warhammercasey/MDS_PCB/SilkscreenDecal/robot_dog_pcb_decal_v2/dog_decal_silkscreen_1200dpi.png

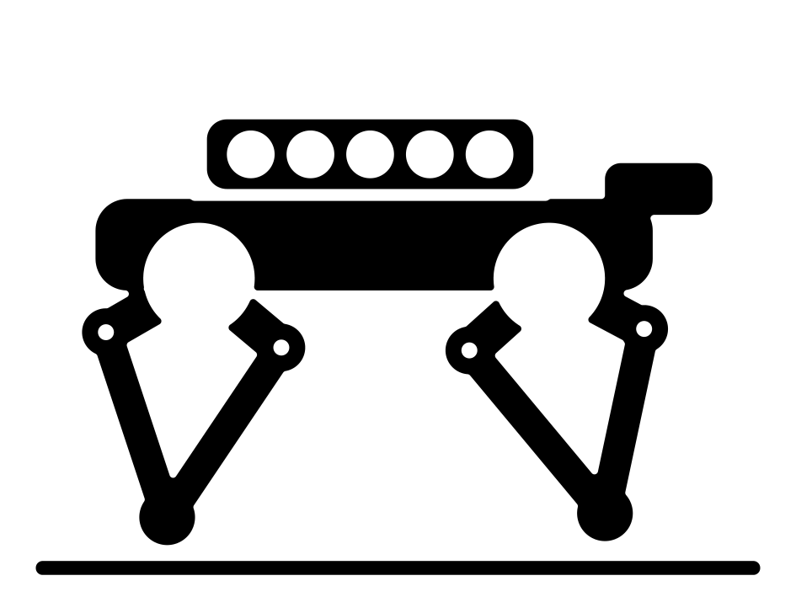
SilkscreenDecal/robot_dog_pcb_decal_v2/dog_decal_silkscreen_1200dpi.png
