warhammercasey/MDS_PCB/SilkscreenDecal/robot_dog_pcb_decal_v2/preview_black.png

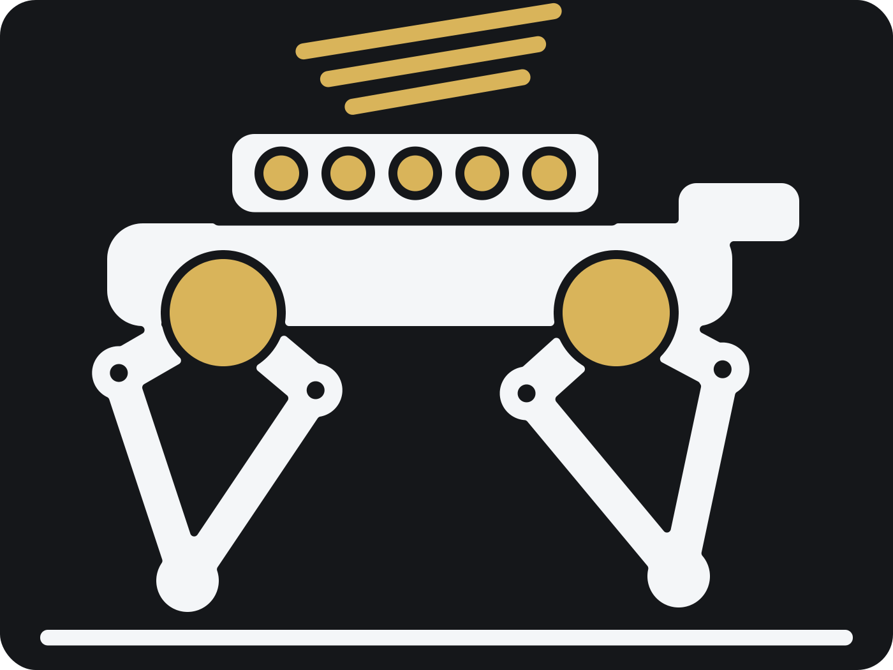
SilkscreenDecal/robot_dog_pcb_decal_v2/preview_black.png
