warhammercasey/MDS_PCB/fpga_pcb.kicad_pcb

## KiCad design fpga_pcb.kicad_pcb (2026-09-30)

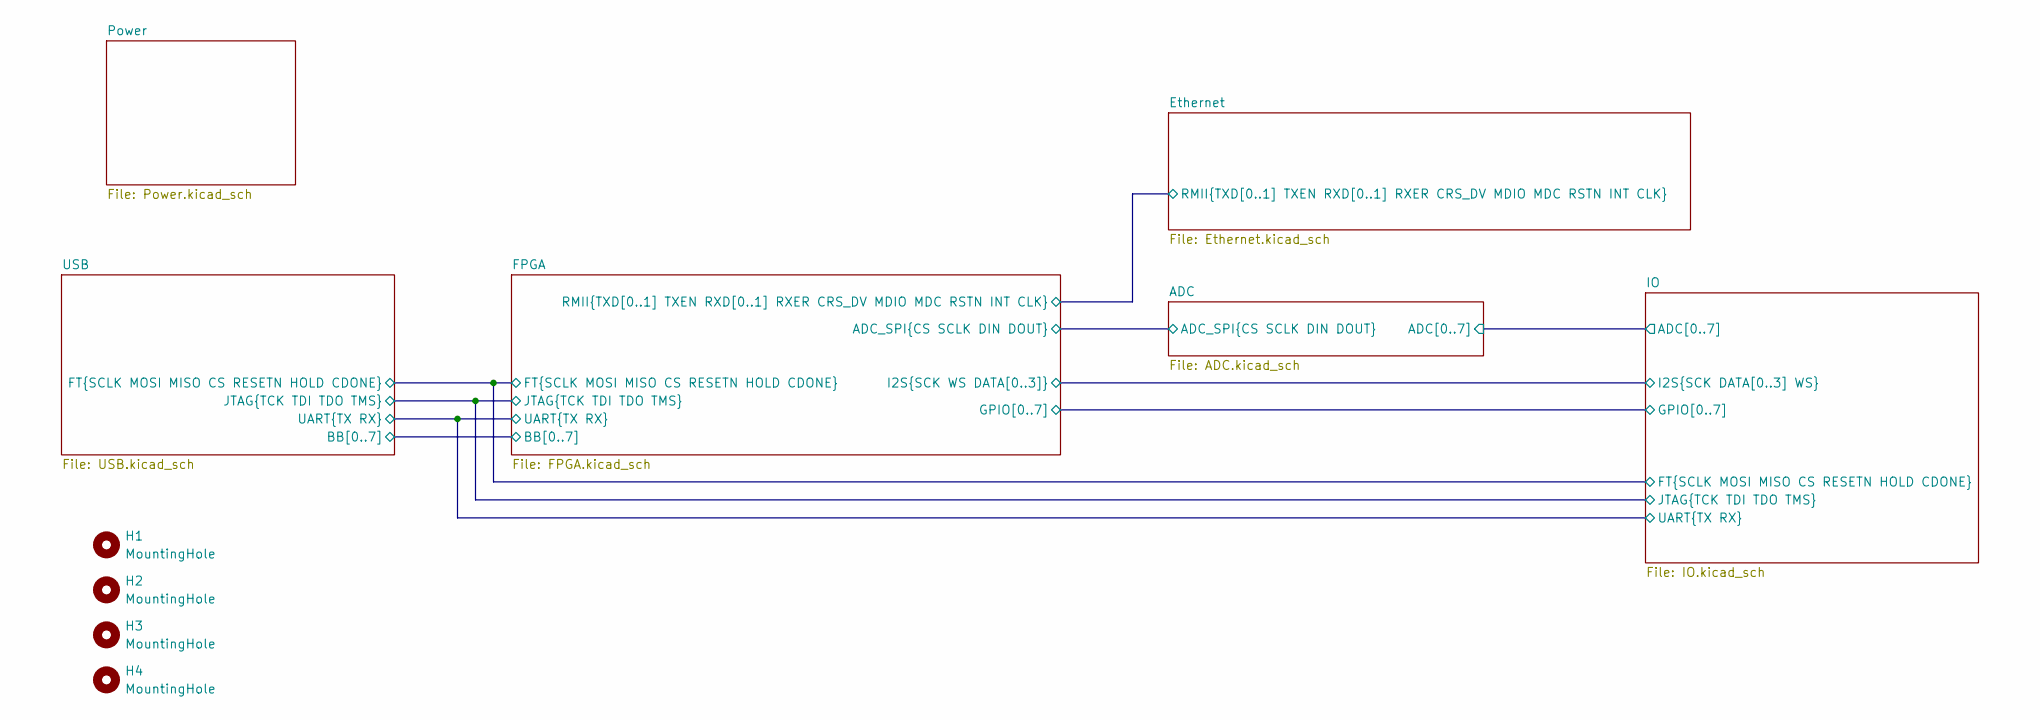
[picture p11: schematic fpga_pcb.kicad_sch, FPGA PCB Top]

Parts:
H1, H2, H3, H4: MountingHole; MountingHole_3.2mm_M3_DIN965_Pad

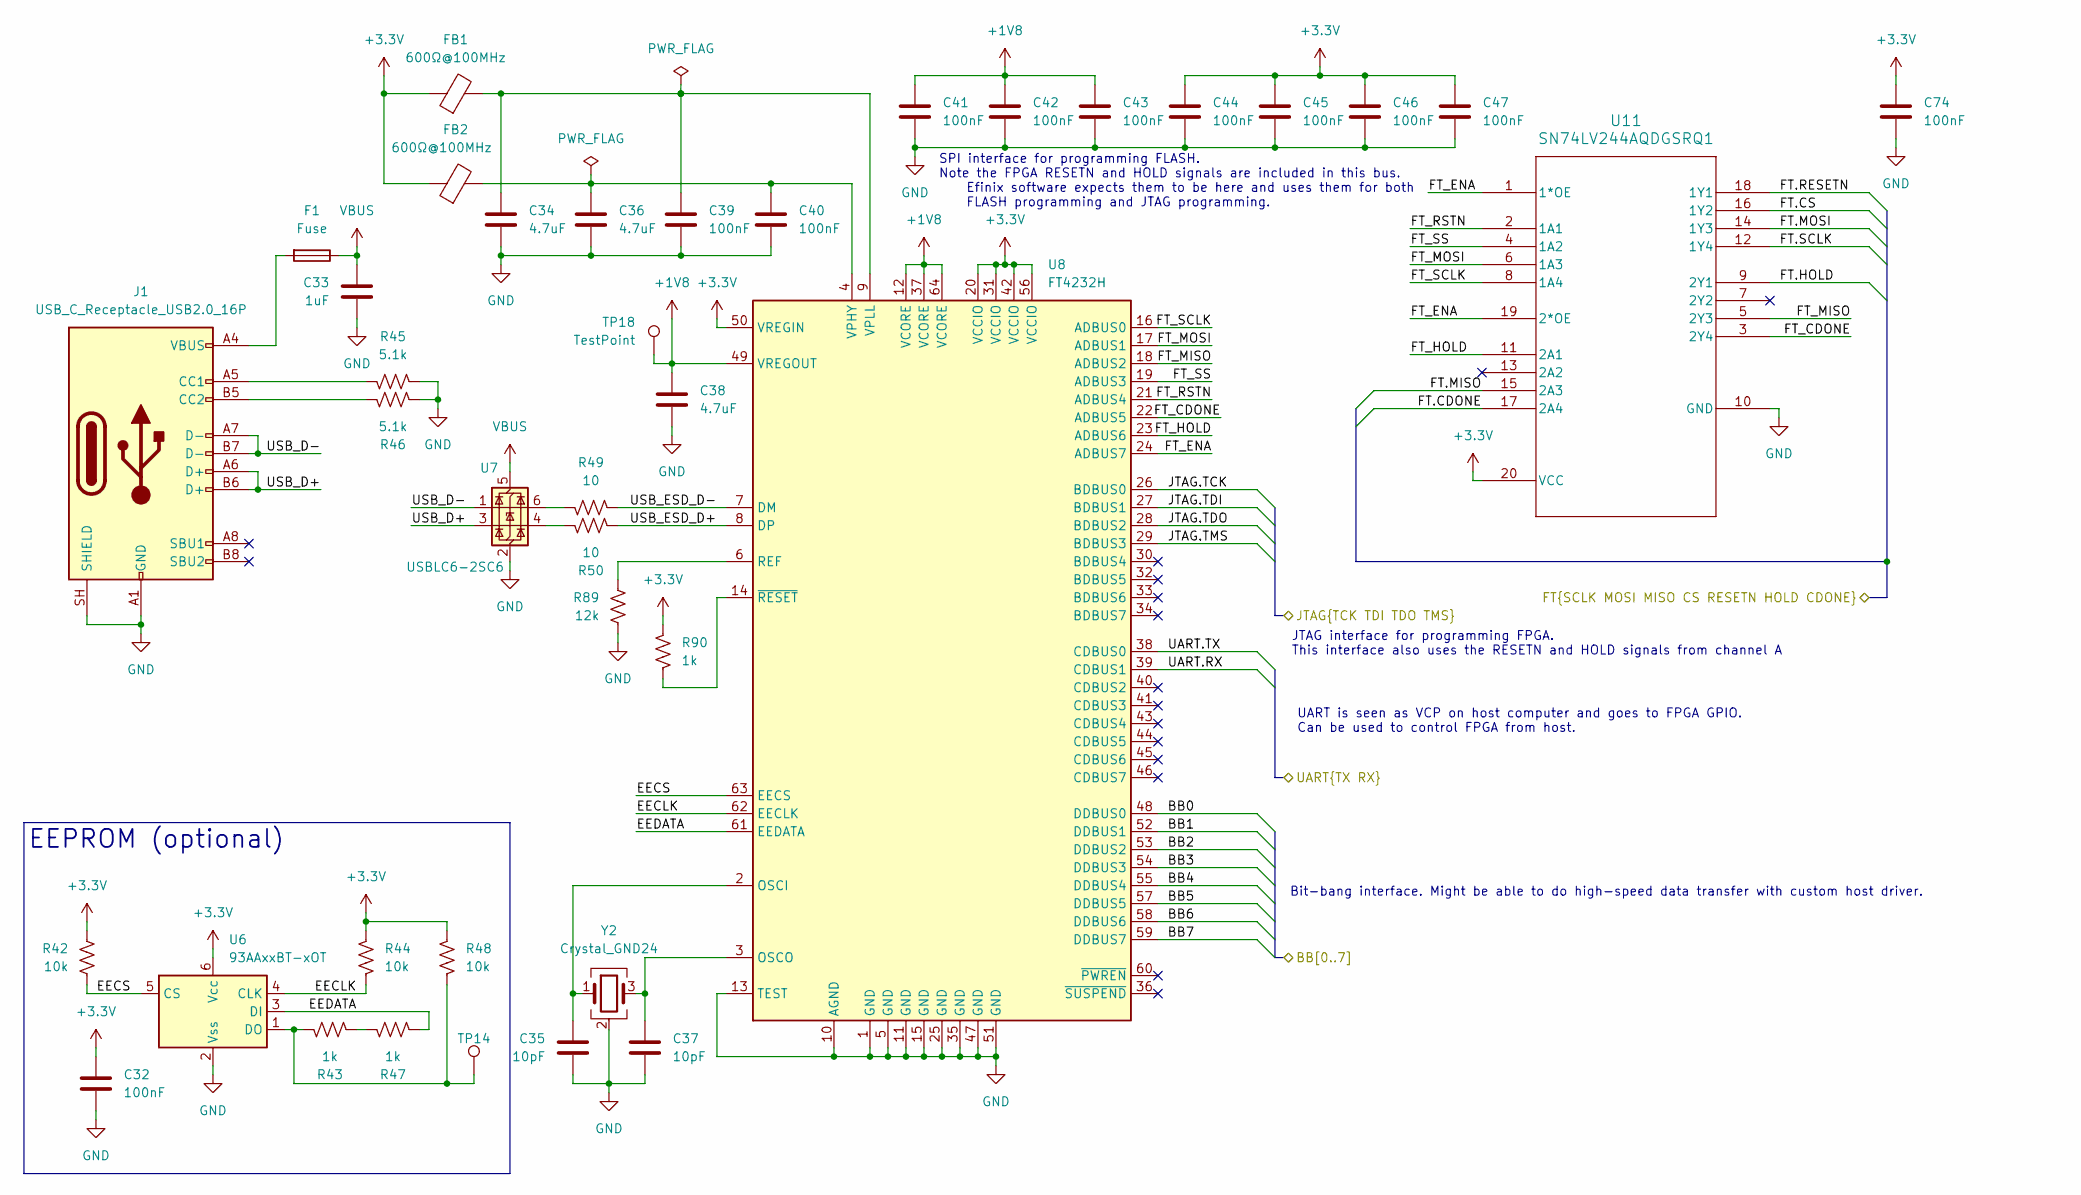
[picture p12: schematic USB.kicad_sch]

Parts:
C32, C39, C40, C41, C42, C43, C44, C45, C46, C47, C74: 100nF; C_0603_1608Metric; Digikey PN 1276-6854-1-ND
C33: 1uF; C_0603_1608Metric; Digikey PN 1276-1859-1-ND
C34, C36, C38: 4.7uF; C_0603_1608Metric; Digikey PN 1276-1045-1-ND
C35, C37: 10pF; C_0603_1608Metric; Digikey PN 1276-2149-1-ND
F1: Fuse; Fuse_0603_1608Metric; Digikey PN 5923-0686F7000-01CT-ND
FB1, FB2: 600Ω@100MHz; L_0603_1608Metric; Digikey PN 490-1014-1-ND
J1: USB_C_Receptacle_USB2.0_16P; USB_C_Receptacle_GCT_USB4105-xx-A_16P_TopMnt_Horizontal; Digikey PN 2073-USB4105-GF-ACT-ND
R42, R44, R48: 10k; R_0603_1608Metric; Digikey PN 311-10KLDCT-ND
R43, R47, R90: 1k; R_0603_1608Metric; Digikey PN 311-1.00KHRCT-ND
R45, R46: 5.1k; R_0603_1608Metric; Digikey PN 311-5.1KGRCT-ND
R49, R50: 10; R_0603_1608Metric; Digikey PN 311-10LDCT-ND
R89: 12k; R_0603_1608Metric; Digikey PN 311-12.0KHRCT-ND
TP14, TP18: TestPoint; TestPoint_Pad_D1.0mm
U6: 93AAxxBT-xOT; SOT-23-6; Digikey PN 93AA56BT-I/OTCT-ND
U7: USBLC6-2SC6; SOT-23-6; Mfr # USBLC6-2SC6; Digikey PN 497-5235-1-ND
U8: FT4232H; LQFP-64_10x10mm_P0.5mm
U11: SN74LV244AQDGSRQ1; VSSOP20_DGS_TEX; Digikey PN 296-SN74LV244AQDGSRQ1CT-ND
Y2: Crystal_GND24; Crystal_SMD_3225-4Pin_3.2x2.5mm; Digikey PN 2151-RH100-12.000-10-3030-TRCT-ND

Connections:
+1V8: C38.1, C41.1, C42.1, C43.1, TP18.1 (1_1), U8.12 (VCORE), U8.37 (VCORE), U8.49 (VREGOUT), U8.64 (VCORE)
+3.3V: C32.1, C44.1, C45.1, C46.1, C47.1, C74.1, FB1.1, FB2.1, R42.1, R44.1, R48.1, R90.1, U6.6 (Vcc), U8.20 (VCCIO), U8.31 (VCCIO), U8.42 (VCCIO), U8.50 (VREGIN), U8.56 (VCCIO), U11.20 (VCC); also elsewhere on the board
/FPGA/BB0: U8.48 (DDBUS0); also elsewhere on the board
/FPGA/BB1: U8.52 (DDBUS1); also elsewhere on the board
/FPGA/BB2: U8.53 (DDBUS2); also elsewhere on the board
/FPGA/BB3: U8.54 (DDBUS3); also elsewhere on the board
/FPGA/BB4: U8.55 (DDBUS4); also elsewhere on the board
/FPGA/BB5: U8.57 (DDBUS5); also elsewhere on the board
/FPGA/BB6: U8.58 (DDBUS6); also elsewhere on the board
/FPGA/BB7: U8.59 (DDBUS7); also elsewhere on the board
/FPGA/FT.CDONE: U11.17 (2A4); also elsewhere on the board
/FPGA/FT.CS: U11.16 (1Y2); also elsewhere on the board
/FPGA/FT.HOLD: U11.9 (2Y1); also elsewhere on the board
/FPGA/FT.MISO: U11.15 (2A3); also elsewhere on the board
/FPGA/FT.MOSI: U11.14 (1Y3); also elsewhere on the board
/FPGA/FT.RESETN: U11.18 (1Y1); also elsewhere on the board
/FPGA/FT.SCLK: U11.12 (1Y4); also elsewhere on the board
/FPGA/JTAG.TCK: U8.26 (BDBUS0); also elsewhere on the board
/FPGA/JTAG.TDI: U8.27 (BDBUS1); also elsewhere on the board
/FPGA/JTAG.TDO: U8.28 (BDBUS2); also elsewhere on the board
/FPGA/JTAG.TMS: U8.29 (BDBUS3); also elsewhere on the board
/FPGA/UART.RX: U8.39 (CDBUS1); also elsewhere on the board
/FPGA/UART.TX: U8.38 (CDBUS0); also elsewhere on the board
/USB/EECLK: R44.2, U6.4 (CLK), U8.62 (EECLK)
/USB/EECS: R42.2, U6.5 (CS), U8.63 (EECS)
/USB/EEDATA: R47.2, U6.3 (DI), U8.61 (EEDATA)
/USB/FT_CDONE: U8.22 (ADBUS5), U11.3 (2Y4)
/USB/FT_ENA: U8.24 (ADBUS7), U11.1 (1*OE), U11.19 (2*OE)
/USB/FT_HOLD: U8.23 (ADBUS6), U11.11 (2A1)
/USB/FT_MISO: U8.18 (ADBUS2), U11.5 (2Y3)
/USB/FT_MOSI: U8.17 (ADBUS1), U11.6 (1A3)
/USB/FT_RSTN: U8.21 (ADBUS4), U11.2 (1A1)
/USB/FT_SCLK: U8.16 (ADBUS0), U11.8 (1A4)
/USB/FT_SS: U8.19 (ADBUS3), U11.4 (1A2)
/USB/USB_D+: J1.A6 (D+), J1.B6 (D+), U7.3 (I/O2)
/USB/USB_D-: J1.A7 (D-), J1.B7 (D-), U7.1 (I/O1)
/USB/USB_ESD_D+: R50.1, U8.8 (DP)
/USB/USB_ESD_D-: R49.1, U8.7 (DM)
GND: C32.2, C33.2, C34.2, C35.2, C36.2, C37.2, C38.2, C39.2, C40.2, C41.2, C42.2, C43.2, C44.2, C45.2, C46.2, C47.2, C74.2, J1.A1 (GND), J1.A12 (GND), J1.B1 (GND), J1.B12 (GND), J1.SH (SHIELD), R45.1, R46.2, R89.2, U6.2 (Vss), U7.2 (GND), U8.1 (GND), U8.5 (GND), U8.10 (AGND), U8.11 (GND), U8.13 (TEST), U8.15 (GND), U8.25 (GND), U8.35 (GND), U8.47 (GND), U8.51 (GND), U11.10 (GND), Y2.2 (G), Y2.4 (G); also elsewhere on the board
unnamed: F1.2, J1.A4 (VBUS), J1.A9 (VBUS), J1.B4 (VBUS), J1.B9 (VBUS)
unnamed: J1.A5 (CC1), R45.2
unnamed: J1.B5 (CC2), R46.1
unnamed: R43.1, R47.1
unnamed: R49.2, U7.6 (I/O1)
unnamed: R50.2, U7.4 (I/O2)
unnamed: R43.2, R48.2, TP14.1 (1_1), U6.1 (DO)
unnamed: C35.1, U8.2 (OSCI), Y2.1
unnamed: C37.1, U8.3 (OSCO), Y2.3
unnamed: R89.1, U8.6 (REF)
unnamed: C36.1, C40.1, FB2.2, U8.4 (VPHY)
unnamed: C34.1, C39.1, FB1.2, U8.9 (VPLL)
unnamed: R90.2, U8.14 (~RESET)
VBUS: C33.1, F1.1, U7.5 (VBUS); also elsewhere on the board

Notes on the sheet:
EEPROM (optional)
SPI interface for programming FLASH. Note the FPGA RESETN and HOLD signals are included in this bus. Efinix software expects them to be here and uses them for both FLASH programming and JTAG programming.
UART is seen as VCP on host computer and goes to FPGA GPIO. Can be used to control FPGA from host.
JTAG interface for programming FPGA. This interface also uses the RESETN and HOLD signals from channel A
Bit-bang interface. Might be able to do high-speed data transfer with custom host driver.

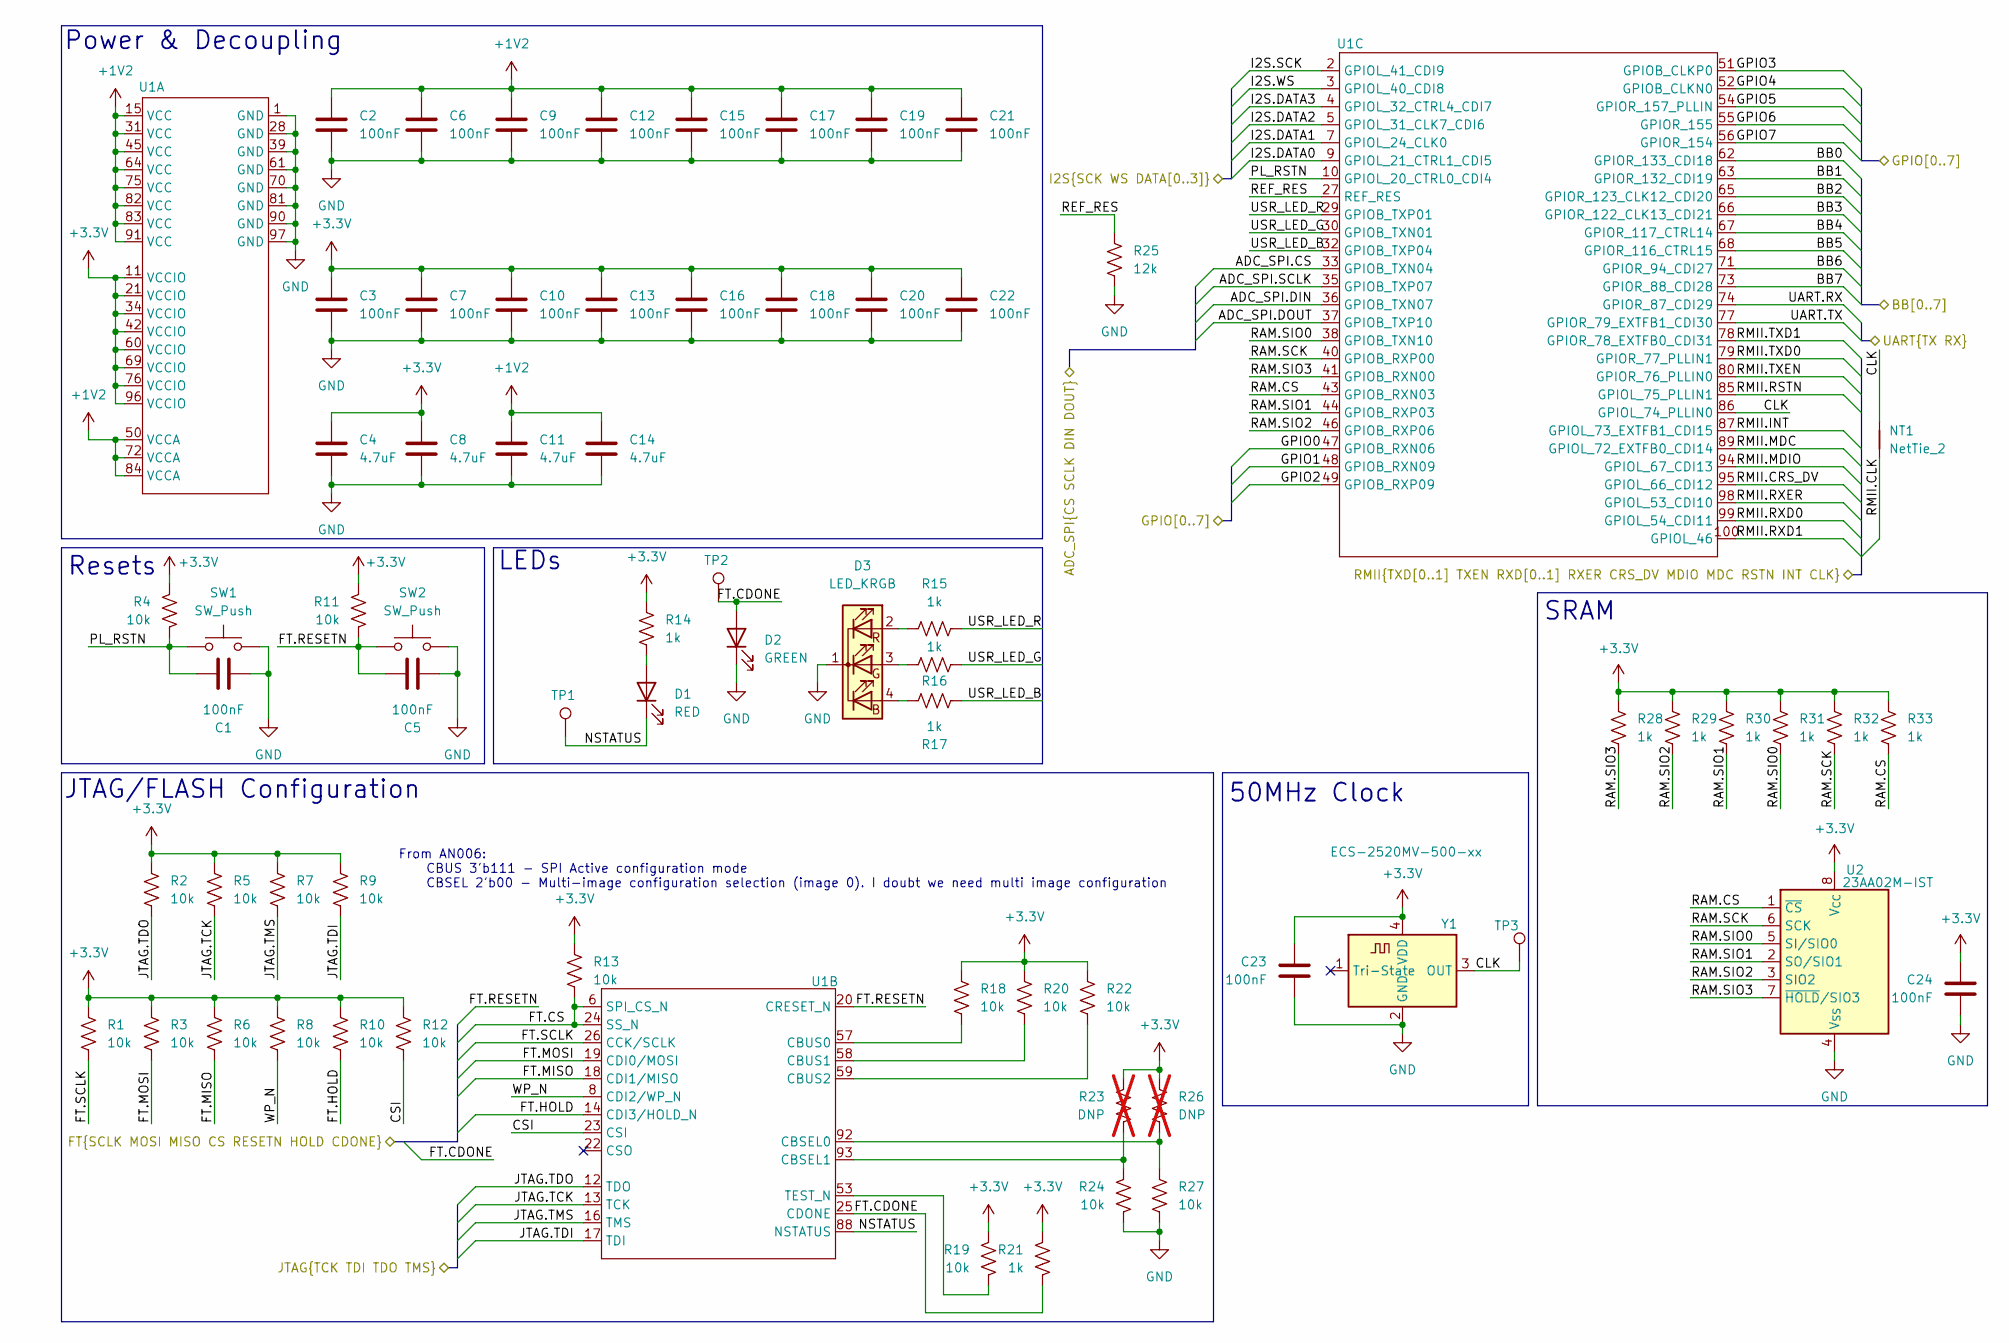
[picture p13: schematic FPGA.kicad_sch]

Parts:
C1, C2, C3, C5, C6, C7, C9, C10, C12, C13, C15, C16, C17, C18, C19, C20, C21, C22, C23, C24: 100nF; C_0603_1608Metric; Digikey PN 1276-6854-1-ND
C4, C8, C11, C14: 4.7uF; C_0603_1608Metric; Digikey PN 1276-1045-1-ND
D1: RED; LED_0603_1608Metric; Digikey PN 754-1123-1-ND
D2: GREEN; LED_0603_1608Metric; Digikey PN 754-1121-1-ND
D3: LED_KRGB; LED_LiteOn_LTST-C19HE1WT; Digikey PN 160-2162-1-ND
NT1: NetTie_2; NetTie-2_SMD_Pad0.5mm
R1, R2, R3, R4, R5, R6, R7, R8, R9, R10, R11, R12, R13, R18, R19, R20, R22, R24, R27: 10k; R_0603_1608Metric; Digikey PN 311-10KLDCT-ND
R14, R15, R16, R17, R21, R28, R29, R30, R31, R32, R33: 1k; R_0603_1608Metric; Digikey PN 311-1.00KHRCT-ND
R23, R26: DNP; R_0603_1608Metric; not fitted
R25: 12k; R_0603_1608Metric; Digikey PN 311-12.0KHRCT-ND
SW1, SW2: SW_Push; SW_Push_1P1T_NO_CK_KMR2; Digikey PN CKN10244CT-ND
TP1, TP2, TP3: TestPoint; TestPoint_Pad_D1.0mm
U1: LQFP-100_14x14mm_P0.5mm; DigiKey PN 2134-T20Q100F3C3-ND
U2: 23AA02M-IST; TSSOP-8_4.4x3mm_P0.65mm; Digikey PN 150-23AA02M-I/ST-ND
Y1: ECS-2520MV-500-xx; Oscillator_SMD_ECS_2520MV-xxx-xx-4Pin_2.5x2.0mm; Digikey PN XC2758CT-ND

Connections:
+1V2: C2.1, C6.1, C9.1, C11.1, C12.1, C14.1, C15.1, C17.1, C19.1, C21.1, U1.15 (VCC), U1.31 (VCC), U1.45 (VCC), U1.50 (VCCA), U1.64 (VCC), U1.72 (VCCA), U1.75 (VCC), U1.82 (VCC), U1.83 (VCC), U1.84 (VCCA), U1.91 (VCC); also elsewhere on the board
+3.3V: C3.1, C4.1, C7.1, C8.1, C10.1, C13.1, C16.1, C18.1, C20.1, C22.1, C23.1, C24.1, R1.1, R2.1, R3.1, R4.1, R5.1, R6.1, R7.1, R8.1, R9.1, R10.1, R11.1, R12.1, R13.1, R14.1, R18.1, R19.1, R20.1, R21.1, R22.1, R23.1, R26.1, R28.1, R29.1, R30.1, R31.1, R32.1, R33.1, U1.11 (VCCIO), U1.21 (VCCIO), U1.34 (VCCIO), U1.42 (VCCIO), U1.60 (VCCIO), U1.69 (VCCIO), U1.76 (VCCIO), U1.96 (VCCIO), U2.8 (V_{CC}), Y1.4 (VDD); also elsewhere on the board
/ADC/ADC_SPI.CS: U1.33 (GPIOB_TXN04); also elsewhere on the board
/ADC/ADC_SPI.DIN: U1.36 (GPIOB_TXN07); also elsewhere on the board
/ADC/ADC_SPI.DOUT: U1.37 (GPIOB_TXP10); also elsewhere on the board
/ADC/ADC_SPI.SCLK: U1.35 (GPIOB_TXP07); also elsewhere on the board
/Ethernet/RMII.CLK: NT1.1; also elsewhere on the board
/Ethernet/RMII.CRS_DV: U1.95 (GPIOL_66_CDI12); also elsewhere on the board
/Ethernet/RMII.INT: U1.87 (GPIOL_73_EXTFB1_CDI15); also elsewhere on the board
/Ethernet/RMII.MDC: U1.89 (GPIOL_72_EXTFB0_CDI14); also elsewhere on the board
/Ethernet/RMII.MDIO: U1.94 (GPIOL_67_CDI13); also elsewhere on the board
/Ethernet/RMII.RSTN: U1.85 (GPIOL_75_PLLIN1); also elsewhere on the board
/Ethernet/RMII.RXD0: U1.99 (GPIOL_54_CDI11); also elsewhere on the board
/Ethernet/RMII.RXD1: U1.100 (GPIOL_46); also elsewhere on the board
/Ethernet/RMII.RXER: U1.98 (GPIOL_53_CDI10); also elsewhere on the board
/Ethernet/RMII.TXD0: U1.79 (GPIOR_77_PLLIN1); also elsewhere on the board
/Ethernet/RMII.TXD1: U1.78 (GPIOR_78_EXTFB0_CDI31); also elsewhere on the board
/Ethernet/RMII.TXEN: U1.80 (GPIOR_76_PLLIN0); also elsewhere on the board
/FPGA/BB0: U1.62 (GPIOR_133_CDI18); also elsewhere on the board
/FPGA/BB1: U1.63 (GPIOR_132_CDI19); also elsewhere on the board
/FPGA/BB2: U1.65 (GPIOR_123_CLK12_CDI20); also elsewhere on the board
/FPGA/BB3: U1.66 (GPIOR_122_CLK13_CDI21); also elsewhere on the board
/FPGA/BB4: U1.67 (GPIOR_117_CTRL14); also elsewhere on the board
/FPGA/BB5: U1.68 (GPIOR_116_CTRL15); also elsewhere on the board
/FPGA/BB6: U1.71 (GPIOR_94_CDI27); also elsewhere on the board
/FPGA/BB7: U1.73 (GPIOR_88_CDI28); also elsewhere on the board
/FPGA/CLK: NT1.2, TP3.1 (1_1), U1.86 (GPIOL_74_PLLIN0), Y1.3 (OUT)
/FPGA/CSI: R12.2, U1.23 (CSI)
/FPGA/FT.CDONE: D2.2 (A), R21.2, TP2.1 (1_1), U1.25 (CDONE); also elsewhere on the board
/FPGA/FT.CS: R13.2, U1.6 (SPI_CS_N), U1.24 (SS_N); also elsewhere on the board
/FPGA/FT.HOLD: R10.2, U1.14 (CDI3/HOLD_N); also elsewhere on the board
/FPGA/FT.MISO: R6.2, U1.18 (CDI1/MISO); also elsewhere on the board
/FPGA/FT.MOSI: R3.2, U1.19 (CDI0/MOSI); also elsewhere on the board
/FPGA/FT.RESETN: C5.2, R11.2, SW2.1, U1.20 (CRESET_N); also elsewhere on the board
/FPGA/FT.SCLK: R1.2, U1.26 (CCK/SCLK); also elsewhere on the board
/FPGA/GPIO0: U1.47 (GPIOB_RXN06); also elsewhere on the board
/FPGA/GPIO1: U1.48 (GPIOB_RXN09); also elsewhere on the board
/FPGA/GPIO2: U1.49 (GPIOB_RXP09); also elsewhere on the board
/FPGA/GPIO3: U1.51 (GPIOB_CLKP0); also elsewhere on the board
/FPGA/GPIO4: U1.52 (GPIOB_CLKN0); also elsewhere on the board
/FPGA/GPIO5: U1.54 (GPIOR_157_PLLIN); also elsewhere on the board
/FPGA/GPIO6: U1.55 (GPIOR_155); also elsewhere on the board
/FPGA/GPIO7: U1.56 (GPIOR_154); also elsewhere on the board
/FPGA/I2S.DATA0: U1.9 (GPIOL_21_CTRL1_CDI5); also elsewhere on the board
/FPGA/I2S.DATA1: U1.7 (GPIOL_24_CLK0); also elsewhere on the board
/FPGA/I2S.DATA2: U1.5 (GPIOL_31_CLK7_CDI6); also elsewhere on the board
/FPGA/I2S.DATA3: U1.4 (GPIOL_32_CTRL4_CDI7); also elsewhere on the board
/FPGA/I2S.SCK: U1.2 (GPIOL_41_CDI9); also elsewhere on the board
/FPGA/I2S.WS: U1.3 (GPIOL_40_CDI8); also elsewhere on the board
/FPGA/JTAG.TCK: R5.2, U1.13 (TCK); also elsewhere on the board
/FPGA/JTAG.TDI: R9.2, U1.17 (TDI); also elsewhere on the board
/FPGA/JTAG.TDO: R2.2, U1.12 (TDO); also elsewhere on the board
/FPGA/JTAG.TMS: R7.2, U1.16 (TMS); also elsewhere on the board
/FPGA/NSTATUS: D1.1 (K), TP1.1 (1_1), U1.88 (NSTATUS)
/FPGA/PL_RSTN: C1.2, R4.2, SW1.1, U1.10 (GPIOL_20_CTRL0_CDI4)
/FPGA/RAM.CS: R33.2, U1.43 (GPIOB_RXN03), U2.1 (~CS)
/FPGA/RAM.SCK: R32.2, U1.40 (GPIOB_RXP00), U2.6 (SCK)
/FPGA/RAM.SIO0: R31.2, U1.38 (GPIOB_TXN10), U2.5 (SI/SIO0)
/FPGA/RAM.SIO1: R30.2, U1.44 (GPIOB_RXP03), U2.2 (SO/SIO1)
/FPGA/RAM.SIO2: R29.2, U1.46 (GPIOB_RXP06), U2.3 (SIO2)
/FPGA/RAM.SIO3: R28.2, U1.41 (GPIOB_RXN00), U2.7 (~HOLD/SIO3)
/FPGA/REF_RES: R25.1, U1.27 (REF_RES)
/FPGA/UART.RX: U1.74 (GPIOR_87_CDI29); also elsewhere on the board
/FPGA/UART.TX: U1.77 (GPIOR_79_EXTFB1_CDI30); also elsewhere on the board
/FPGA/USR_LED_B: R17.1, U1.32 (GPIOB_TXP04)
/FPGA/USR_LED_G: R16.2, U1.30 (GPIOB_TXN01)
/FPGA/USR_LED_R: R15.2, U1.29 (GPIOB_TXP01)
/FPGA/WP_N: R8.2, U1.8 (CDI2/WP_N)
GND: C1.1, C2.2, C3.2, C4.2, C5.1, C6.2, C7.2, C8.2, C9.2, C10.2, C11.2, C12.2, C13.2, C14.2, C15.2, C16.2, C17.2, C18.2, C19.2, C20.2, C21.2, C22.2, C23.2, C24.2, D2.1 (K), D3.1 (K), R24.2, R25.2, R27.2, SW1.2, SW2.2, U1.1 (GND), U1.28 (GND), U1.39 (GND), U1.61 (GND), U1.70 (GND), U1.81 (GND), U1.90 (GND), U1.97 (GND), U2.4 (V_{SS}), Y1.2 (GND); also elsewhere on the board
unnamed: D1.2 (A), R14.2
unnamed: D3.4 (BA), R17.2
unnamed: D3.3 (GA), R16.1
unnamed: D3.2 (RA), R15.1
unnamed: R26.2, R27.1, U1.92 (CBSEL0)
unnamed: R23.2, R24.1, U1.93 (CBSEL1)
unnamed: R18.2, U1.57 (CBUS0)
unnamed: R20.2, U1.58 (CBUS1)
unnamed: R22.2, U1.59 (CBUS2)
unnamed: R19.2, U1.53 (TEST_N)

Notes on the sheet:
JTAG/FLASH Configuration
LEDs
SRAM
Power & Decoupling
50MHz Clock
Resets
From AN006: CBUS 3'b111 - SPI Active configuration mode CBSEL 2'b00 - Multi-image configuration selection (image 0). I doubt we need multi image configuration

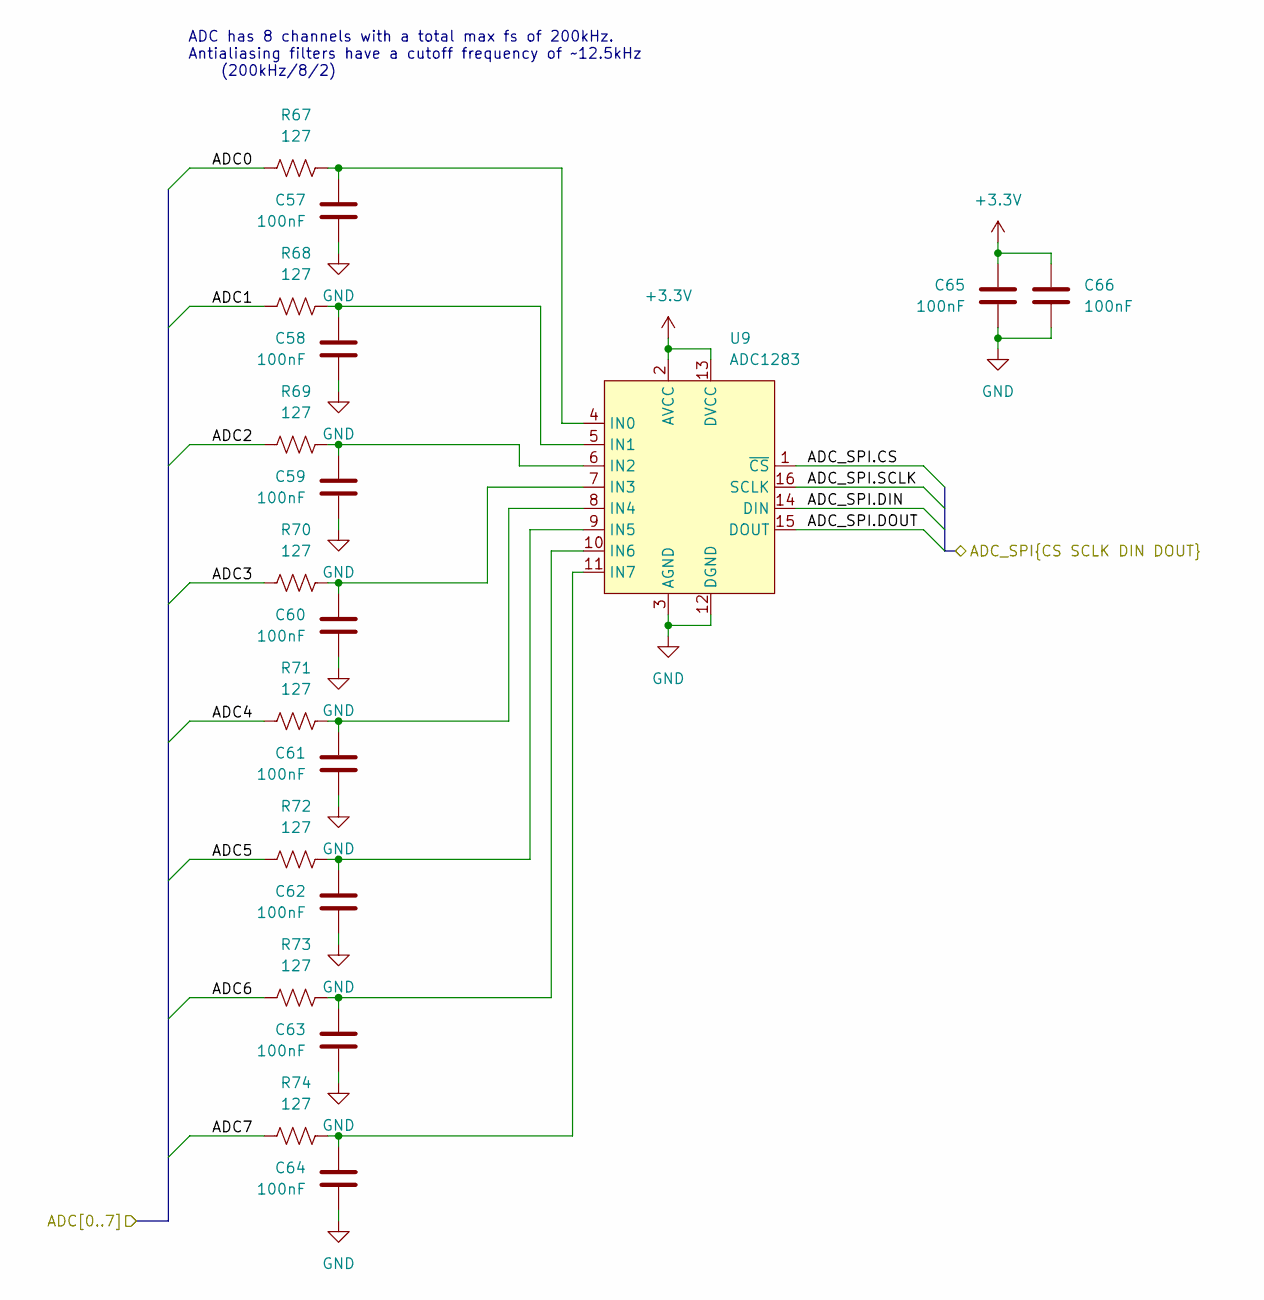
[picture p14: schematic ADC.kicad_sch]

Parts:
C57, C58, C59, C60, C61, C62, C63, C64, C65, C66: 100nF; C_0603_1608Metric; Digikey PN 1276-6854-1-ND
R67, R68, R69, R70, R71, R72, R73, R74: 127; R_0603_1608Metric; Digikey PN 311-127HRCT-ND
U9: ADC1283; TSSOP-16_4.4x5mm_P0.65mm; Digikey PN ADC088S022CIMTX/NOPBCT-ND

Connections:
+3.3V: C65.1, C66.1, U9.2 (AVCC), U9.13 (DVCC); also elsewhere on the board
/ADC/ADC0: R67.1; also elsewhere on the board
/ADC/ADC1: R68.1; also elsewhere on the board
/ADC/ADC2: R69.1; also elsewhere on the board
/ADC/ADC3: R70.1; also elsewhere on the board
/ADC/ADC4: R71.1; also elsewhere on the board
/ADC/ADC5: R72.1; also elsewhere on the board
/ADC/ADC6: R73.1; also elsewhere on the board
/ADC/ADC7: R74.1; also elsewhere on the board
/ADC/ADC_SPI.CS: U9.1 (~CS); also elsewhere on the board
/ADC/ADC_SPI.DIN: U9.14 (DIN); also elsewhere on the board
/ADC/ADC_SPI.DOUT: U9.15 (DOUT); also elsewhere on the board
/ADC/ADC_SPI.SCLK: U9.16 (SCLK); also elsewhere on the board
GND: C57.2, C58.2, C59.2, C60.2, C61.2, C62.2, C63.2, C64.2, C65.2, C66.2, U9.3 (AGND), U9.12 (DGND); also elsewhere on the board
unnamed: C57.1, R67.2, U9.4 (IN0)
unnamed: C58.1, R68.2, U9.5 (IN1)
unnamed: C59.1, R69.2, U9.6 (IN2)
unnamed: C60.1, R70.2, U9.7 (IN3)
unnamed: C61.1, R71.2, U9.8 (IN4)
unnamed: C62.1, R72.2, U9.9 (IN5)
unnamed: C63.1, R73.2, U9.10 (IN6)
unnamed: C64.1, R74.2, U9.11 (IN7)

Notes on the sheet:
ADC has 8 channels with a total max fs of 200kHz. Antialiasing filters have a cutoff frequency of ~12.5kHz (200kHz/8/2)

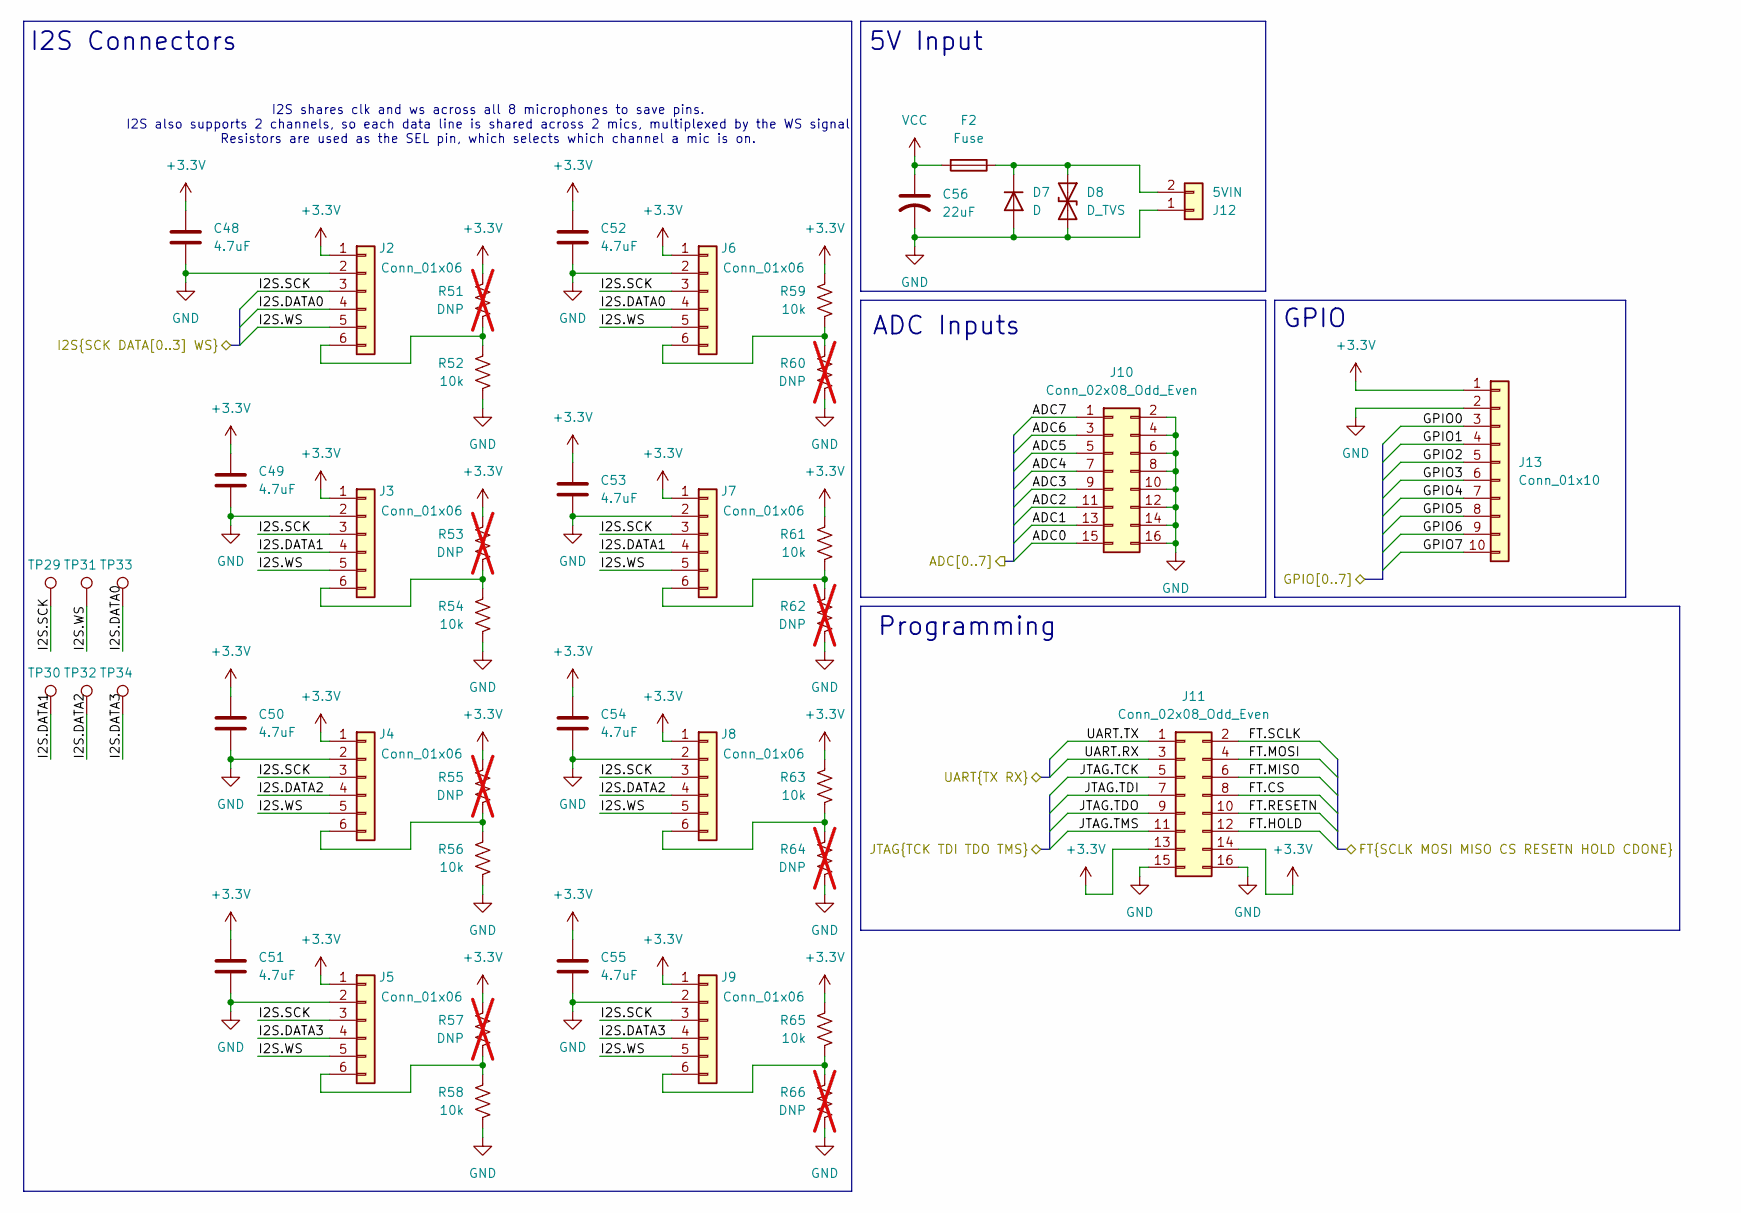
[picture p15: schematic IO.kicad_sch, I/O]

Parts:
C48, C49, C50, C51, C52, C53, C54, C55: 4.7uF; C_0603_1608Metric; Digikey PN 1276-1045-1-ND
C56: 22uF; C_Radial_D5.0mm_H7.0mm_P2.00mm; Digikey PN P814-ND
D7: D; D_SMA; Digikey PN 5399-SS32CT-ND
D8: D_TVS; D_SMA; Digikey PN 5399-SMAJ6.0ACT-ND
F2: Fuse; Fuse_0603_1608Metric; Digikey PN 5923-0686F7000-01CT-ND
J2, J3, J4, J5, J6, J7, J8, J9: Conn_01x06; JST_GH_BM06B-GHS-TBT_1x06-1MP_P1.25mm_Vertical; Digikey PN 455-BM06B-GHS-TBTCT-ND
J10, J11: Conn_02x08_Odd_Even; PinHeader_2x08_P2.54mm_Vertical; Digikey PN 4627-PH254V-216-6TBKG126-ND
J12: 5VIN; JST_XH_B2B-XH-A_1x02_P2.50mm_Vertical; Digikey PN 455-B2B-XH-A-ND
J13: Conn_01x10; PinHeader_1x10_P2.54mm_Vertical; Digikey PN 2057-PH1-10-UA-ND
R51, R53, R55, R57, R60, R62, R64, R66: DNP; R_0603_1608Metric; not fitted
R52, R54, R56, R58, R59, R61, R63, R65: 10k; R_0603_1608Metric; Digikey PN 311-10KLDCT-ND
TP29, TP30, TP31, TP32, TP33, TP34: TestPoint; TestPoint_Pad_D1.0mm

Connections:
+3.3V: C48.1, C49.1, C50.1, C51.1, C52.1, C53.1, C54.1, C55.1, J2.1, J3.1, J4.1, J5.1, J6.1, J7.1, J8.1, J9.1, J11.13, J11.14, J13.1, R51.1, R53.1, R55.1, R57.1, R59.1, R61.1, R63.1, R65.1; also elsewhere on the board
/ADC/ADC0: J10.15; also elsewhere on the board
/ADC/ADC1: J10.13; also elsewhere on the board
/ADC/ADC2: J10.11; also elsewhere on the board
/ADC/ADC3: J10.9; also elsewhere on the board
/ADC/ADC4: J10.7; also elsewhere on the board
/ADC/ADC5: J10.5; also elsewhere on the board
/ADC/ADC6: J10.3; also elsewhere on the board
/ADC/ADC7: J10.1; also elsewhere on the board
/FPGA/FT.CS: J11.8; also elsewhere on the board
/FPGA/FT.HOLD: J11.12; also elsewhere on the board
/FPGA/FT.MISO: J11.6; also elsewhere on the board
/FPGA/FT.MOSI: J11.4; also elsewhere on the board
/FPGA/FT.RESETN: J11.10; also elsewhere on the board
/FPGA/FT.SCLK: J11.2; also elsewhere on the board
/FPGA/GPIO0: J13.3; also elsewhere on the board
/FPGA/GPIO1: J13.4; also elsewhere on the board
/FPGA/GPIO2: J13.5; also elsewhere on the board
/FPGA/GPIO3: J13.6; also elsewhere on the board
/FPGA/GPIO4: J13.7; also elsewhere on the board
/FPGA/GPIO5: J13.8; also elsewhere on the board
/FPGA/GPIO6: J13.9; also elsewhere on the board
/FPGA/GPIO7: J13.10; also elsewhere on the board
/FPGA/I2S.DATA0: J2.4, J6.4, TP33.1 (1_1); also elsewhere on the board
/FPGA/I2S.DATA1: J3.4, J7.4, TP30.1 (1_1); also elsewhere on the board
/FPGA/I2S.DATA2: J4.4, J8.4, TP32.1 (1_1); also elsewhere on the board
/FPGA/I2S.DATA3: J5.4, J9.4, TP34.1 (1_1); also elsewhere on the board
/FPGA/I2S.SCK: J2.3, J3.3, J4.3, J5.3, J6.3, J7.3, J8.3, J9.3, TP29.1 (1_1); also elsewhere on the board
/FPGA/I2S.WS: J2.5, J3.5, J4.5, J5.5, J6.5, J7.5, J8.5, J9.5, TP31.1 (1_1); also elsewhere on the board
/FPGA/JTAG.TCK: J11.5; also elsewhere on the board
/FPGA/JTAG.TDI: J11.7; also elsewhere on the board
/FPGA/JTAG.TDO: J11.9; also elsewhere on the board
/FPGA/JTAG.TMS: J11.11; also elsewhere on the board
/FPGA/UART.RX: J11.3; also elsewhere on the board
/FPGA/UART.TX: J11.1; also elsewhere on the board
GND: C48.2, C49.2, C50.2, C51.2, C52.2, C53.2, C54.2, C55.2, C56.2, D7.2 (A), D8.2 (A2), J2.2, J3.2, J4.2, J5.2, J6.2, J7.2, J8.2, J9.2, J10.2, J10.4, J10.6, J10.8, J10.10, J10.12, J10.14, J10.16, J11.15, J11.16, J12.1, J13.2, R52.2, R54.2, R56.2, R58.2, R60.2, R62.2, R64.2, R66.2; also elsewhere on the board
unnamed: D7.1 (K), D8.1 (A1), F2.1, J12.2
unnamed: J2.6, R51.2, R52.1
unnamed: J3.6, R53.2, R54.1
unnamed: J4.6, R55.2, R56.1
unnamed: J5.6, R57.2, R58.1
unnamed: J6.6, R59.2, R60.1
unnamed: J7.6, R61.2, R62.1
unnamed: J8.6, R63.2, R64.1
unnamed: J9.6, R65.2, R66.1
VCC: C56.1, F2.2; also elsewhere on the board

Notes on the sheet:
I2S Connectors
ADC Inputs
I2S shares clk and ws across all 8 microphones to save pins. I2S also supports 2 channels, so each data line is shared across 2 mics, multiplexed by the WS signal Resistors are used as the SEL pin, which selects which channel a mic is on.
Programming
GPIO
5V Input
