warhammercasey/MDS_PCB/fpga_pcb.kicad_pcb

## KiCad design fpga_pcb.kicad_pcb (continued)

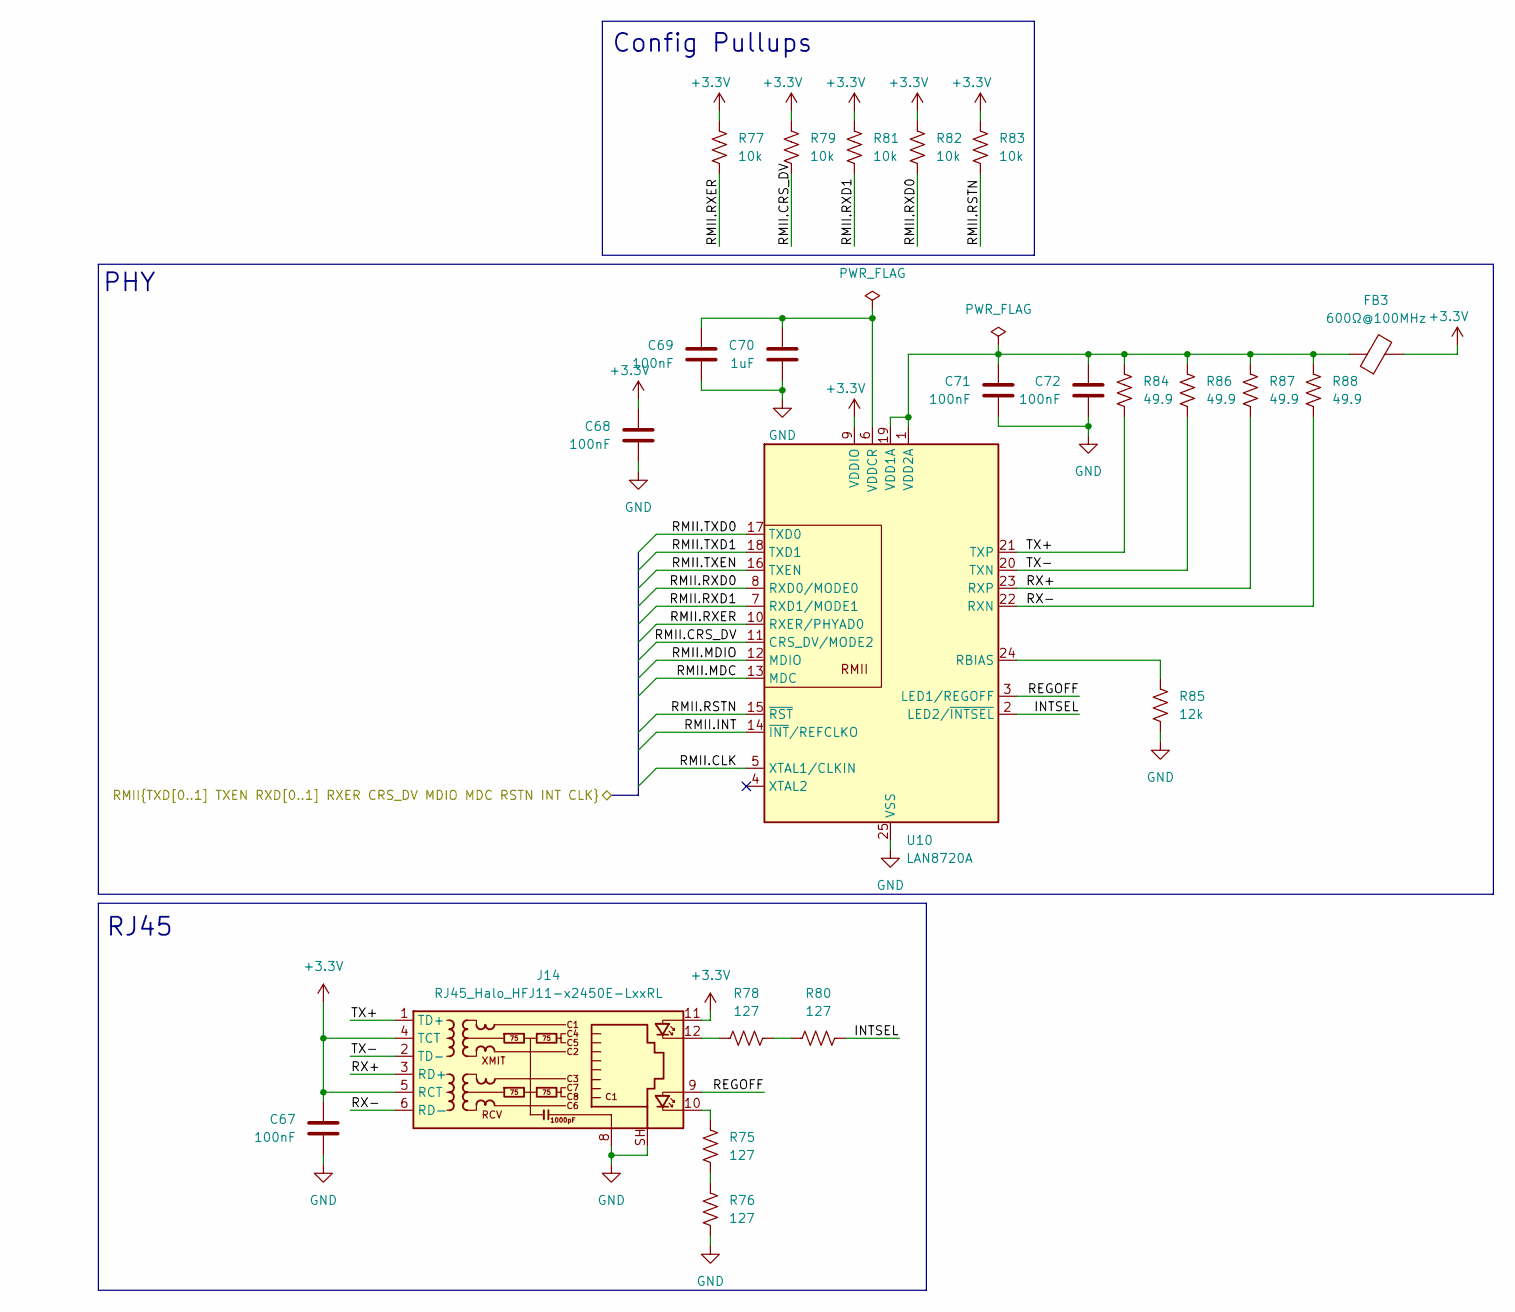
[picture p16: schematic Ethernet.kicad_sch]

Parts:
C67, C68, C69, C71, C72: 100nF; C_0603_1608Metric; Digikey PN 1276-6854-1-ND
C70: 1uF; C_0603_1608Metric; Digikey PN 1276-1859-1-ND
FB3: 600Ω@100MHz; L_0603_1608Metric; Digikey PN 490-1014-1-ND
J14: RJ45_Halo_HFJ11-x2450E-LxxRL; RJ45_HALO_HFJ11-x2450E-LxxRL_Horizontal; Digikey PN 5843-HFJ11-2450E-L12RL-ND
R75, R76, R78, R80: 127; R_0603_1608Metric; Digikey PN 311-127HRCT-ND
R77, R79, R81, R82, R83: 10k; R_0603_1608Metric; Digikey PN 311-10KLDCT-ND
R84, R86, R87, R88: 49.9; R_0603_1608Metric; Digikey PN 311-49.9HRCT-ND
R85: 12k; R_0603_1608Metric; Digikey PN 311-12.0KHRCT-ND
U10: LAN8720A; VQFN-24-1EP_4x4mm_P0.5mm_EP2.5x2.5mm_ThermalVias; Digikey PN LAN8720A-CP-CT-ND

Connections:
+3.3V: C67.1, C68.1, FB3.2, J14.4 (TCT), J14.5 (RCT), J14.11, R77.1, R79.1, R81.1, R82.1, R83.1, U10.9 (VDDIO); also elsewhere on the board
/Ethernet/INTSEL: R80.1, U10.2 (LED2/~INTSEL)
/Ethernet/REGOFF: J14.9, U10.3 (LED1/REGOFF)
/Ethernet/RMII.CLK: U10.5 (XTAL1/CLKIN); also elsewhere on the board
/Ethernet/RMII.CRS_DV: R79.2, U10.11 (CRS_DV/MODE2); also elsewhere on the board
/Ethernet/RMII.INT: U10.14 (~INT/REFCLKO); also elsewhere on the board
/Ethernet/RMII.MDC: U10.13 (MDC); also elsewhere on the board
/Ethernet/RMII.MDIO: U10.12 (MDIO); also elsewhere on the board
/Ethernet/RMII.RSTN: R83.2, U10.15 (~RST); also elsewhere on the board
/Ethernet/RMII.RXD0: R82.2, U10.8 (RXD0/MODE0); also elsewhere on the board
/Ethernet/RMII.RXD1: R81.2, U10.7 (RXD1/MODE1); also elsewhere on the board
/Ethernet/RMII.RXER: R77.2, U10.10 (RXER/PHYAD0); also elsewhere on the board
/Ethernet/RMII.TXD0: U10.17 (TXD0); also elsewhere on the board
/Ethernet/RMII.TXD1: U10.18 (TXD1); also elsewhere on the board
/Ethernet/RMII.TXEN: U10.16 (TXEN); also elsewhere on the board
/Ethernet/RX+: J14.3 (RD+), R87.2, U10.23 (RXP)
/Ethernet/RX-: J14.6 (RD-), R88.2, U10.22 (RXN)
/Ethernet/TX+: J14.1 (TD+), R84.2, U10.21 (TXP)
/Ethernet/TX-: J14.2 (TD-), R86.2, U10.20 (TXN)
GND: C67.2, C68.2, C69.2, C70.2, C71.2, C72.2, J14.8, J14.SH, R76.2, R85.2, U10.25 (VSS); also elsewhere on the board
unnamed: J14.10, R75.1
unnamed: J14.12, R78.2
unnamed: R75.2, R76.1
unnamed: R78.1, R80.2
unnamed: R85.1, U10.24 (RBIAS)
unnamed: C71.1, C72.1, FB3.1, R84.1, R86.1, R87.1, R88.1, U10.1 (VDD2A), U10.19 (VDD1A)
unnamed: C69.1, C70.1, U10.6 (VDDCR)

Notes on the sheet:
RJ45
Config Pullups
PHY

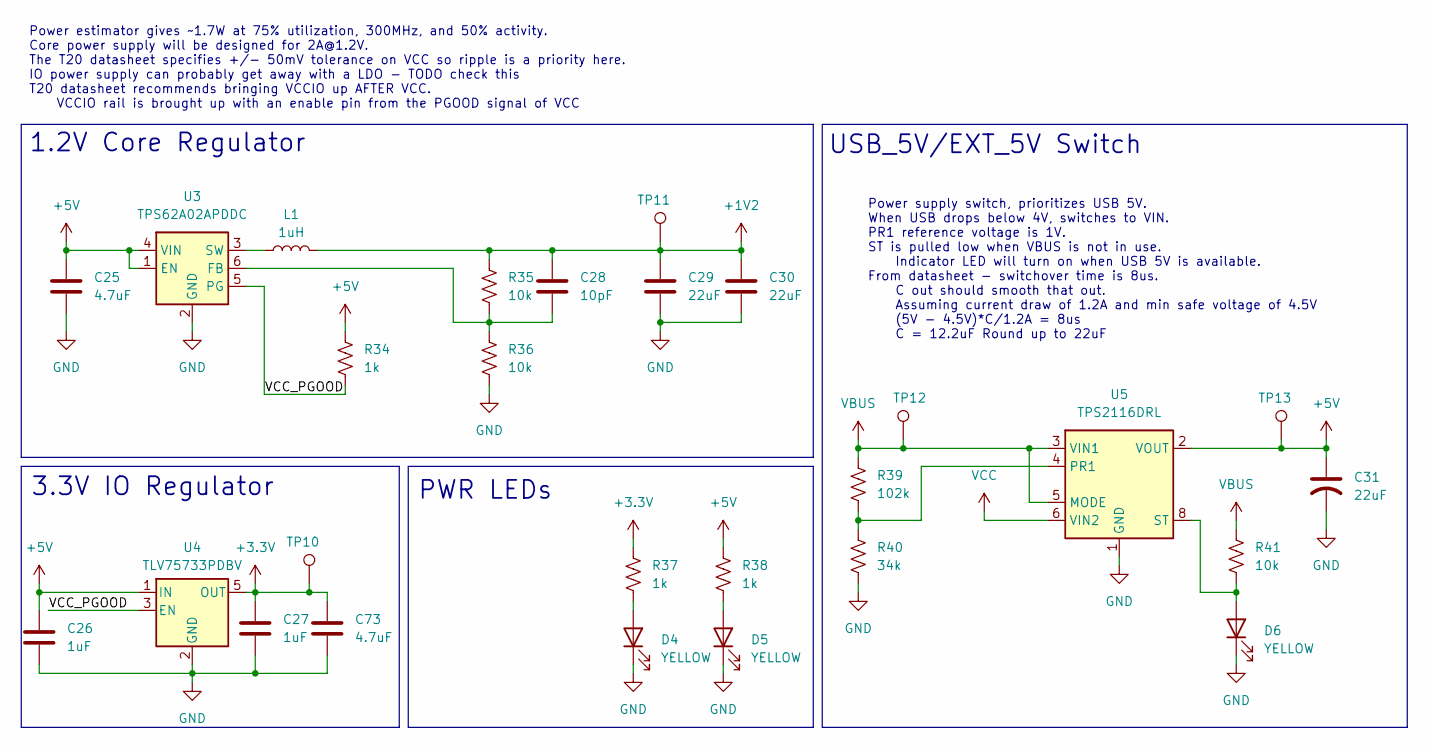
[picture p17: schematic Power.kicad_sch]

Parts:
C25, C73: 4.7uF; C_0603_1608Metric; Digikey PN 1276-1045-1-ND
C26, C27: 1uF; C_0603_1608Metric; Digikey PN 1276-1859-1-ND
C28: 10pF; C_0603_1608Metric; Digikey PN 1276-2149-1-ND
C29, C30: 22uF; C_1206_3216Metric; Digikey PN 1276-2728-1-ND
C31: 22uF; C_Radial_D5.0mm_H7.0mm_P2.00mm; Digikey PN P814-ND
D4, D5, D6: YELLOW; LED_0603_1608Metric; Digikey PN 754-1124-1-ND
L1: 1uH; L_1210_3225Metric; Digikey PN 3526-WIP322512A-1R0MLDGCT-ND
R34, R37, R38: 1k; R_0603_1608Metric; Digikey PN 311-1.00KHRCT-ND
R35, R36, R41: 10k; R_0603_1608Metric; Digikey PN 311-10KLDCT-ND
R39: 102k; R_0603_1608Metric; Digikey PN YAG1498CT-ND
R40: 34k; R_0603_1608Metric; Digikey PN 311-34.0KHRCT-ND
TP10, TP11, TP12, TP13: TestPoint; TestPoint_Pad_D1.0mm
U3: TPS62A02APDDC; SOT-23-6; Digikey PN 296-TPS62A02APDDCRCT-ND
U4: TLV75733PDBV; SOT-23-5; Digikey PN 296-TLV75733PDYDRCT-ND
U5: TPS2116DRL; SOT-583-8; Digikey PN 296-TPS2116DRLRCT-ND

Connections:
+1V2: C28.1, C29.1, C30.1, L1.2, R35.1, TP11.1 (1_1); also elsewhere on the board
+3.3V: C27.1, C73.1, R37.1, TP10.1 (1_1), U4.5 (OUT); also elsewhere on the board
+5V: C25.1, C26.1, C31.1, R34.1, R38.1, TP13.1 (1_1), U3.1 (EN), U3.4 (VIN), U4.1 (IN), U5.2 (VOUT), U5.7 (VOUT)
/Power/VCC_PGOOD: R34.2, U3.5 (PG), U4.3 (EN)
GND: C25.2, C26.2, C27.2, C29.2, C30.2, C31.2, C73.2, D4.1 (K), D5.1 (K), D6.1 (K), R36.2, R40.2, U3.2 (GND), U4.2 (GND), U5.1 (GND); also elsewhere on the board
unnamed: D4.2 (A), R37.2
unnamed: D5.2 (A), R38.2
unnamed: D6.2 (A), R41.2, U5.8 (ST)
unnamed: C28.2, R35.2, R36.1, U3.6 (FB)
unnamed: L1.1, U3.3 (SW)
unnamed: R39.2, R40.1, U5.4 (PR1)
VBUS: R39.1, R41.1, TP12.1 (1_1), U5.3 (VIN1), U5.5 (MODE); also elsewhere on the board
VCC: U5.6 (VIN2); also elsewhere on the board

Notes on the sheet:
USB_5V/EXT_5V Switch
PWR LEDs
Power estimator gives ~1.7W at 75% utilization, 300MHz, and 50% activity. Core power supply will be designed for 2A@1.2V. The T20 datasheet specifies +/- 50mV tolerance on VCC so ripple is a priority here. IO power supply can probably get away with a LDO - TODO check this T20 datasheet recommends b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
1.2V Core Regulator
Power supply switch, prioritizes USB 5V. When USB drops below 4V, switches to VIN. PR1 reference voltage is 1V. ST is pulled low when VBUS is not in use. Indicator LED will turn on when USB 5V is available. From datasheet - switchover time is 8us. C out should smooth that out. Assuming current draw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
3.3V IO Regulator

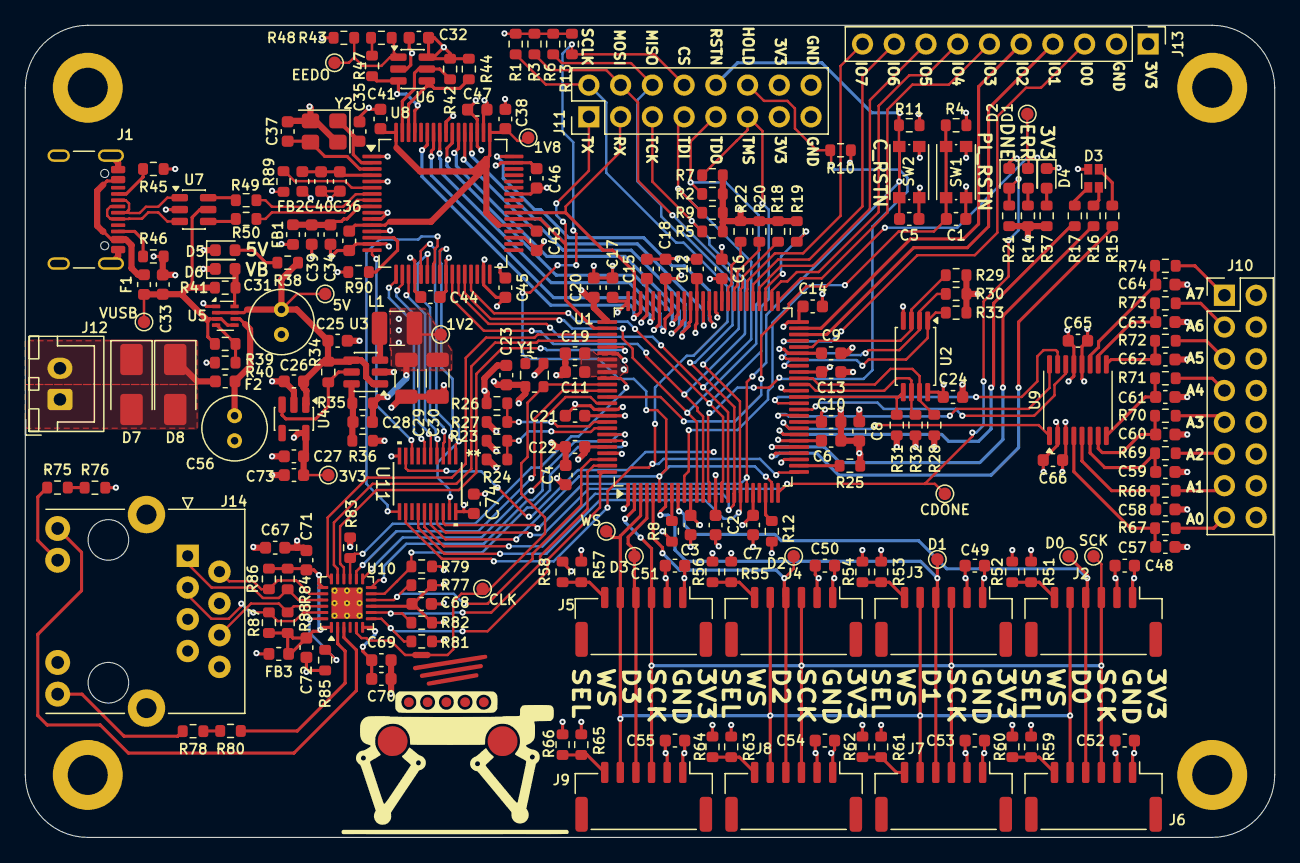
[picture p18: board fpga_pcb.kicad_pcb from above]

Board: 4 copper layers, 100.0 x 65.0 mm, 227 parts (0 on the bottom side), 156 nets.
