warhammercasey/MDS_PCB/(commit log)

2026-09-16 Aded power and USB
    [FPGA.kicad_sch, Power.kicad_sch, USB.kicad_sch, fpga_pcb.kicad_sch, power-estimator-t20-v4.5.xlsm]
2026-09-16 Added ADC
    [ADC.kicad_sch, USB.kicad_sch, fpga_pcb.kicad_sch]
2026-09-18 Added SRAM and removed old ADC
    [ADC.kicad_sch, FPGA.kicad_sch, IO.kicad_sch, Power.kicad_sch, SRAM.kicad_sch, USB.kicad_sch, fpga_pcb.kicad_sch, power-estimator-t20-v4.5.xlsm]
2026-09-18 Initial design
    [ADC.kicad_sch, FPGA.kicad_sch, IO.kicad_sch, Power.kicad_sch, USB.kicad_sch, fpga_pcb.csv, fpga_pcb.kicad_sch, power-estimator-t20-v4.5.xlsm]
2026-09-19 Added ethernet
    [Ethernet.kicad_sch, FPGA.kicad_sch, IO.kicad_sch, Power.kicad_sch, USB.kicad_sch, fpga_pcb.csv, fpga_pcb.kicad_sch]
2026-09-19 Printed schematic to PDF
2026-09-19 Annotated schematic
    [ADC.kicad_sch, Ethernet.kicad_sch, FPGA.kicad_sch, IO.kicad_sch, Power.kicad_sch, USB.kicad_sch]
2026-09-20 Removed old SRAM schematic
    [SRAM.kicad_sch]
2026-09-21 Started module-level layout
    [ADC.kicad_sch, Ethernet.kicad_sch, FPGA.kicad_sch, IO.kicad_sch, Power.kicad_sch, USB.kicad_sch, fpga_pcb.kicad_pcb, fpga_pcb.kicad_sch]
2026-09-21 More layout
    [IO.kicad_sch, fpga_pcb.kicad_pcb]
2026-09-23 Initial layout
    [fpga_pcb.kicad_pcb]
2026-09-27 Routing done
    [ADC.kicad_sch, Ethernet.kicad_sch, FPGA.kicad_sch, IO.kicad_sch, Power.kicad_sch, USB.kicad_sch, fpga_pcb.kicad_pcb, fpga_pcb.kicad_sch]
2026-09-27 Added SPI bus buffer
    [ADC.kicad_sch, Ethernet.kicad_sch, FPGA.kicad_sch, IO.kicad_sch, Power.kicad_sch, USB.kicad_sch, fpga_pcb.kicad_pcb, fpga_pcb.kicad_sch]
2026-09-30 Added decal and gerbers
    [ADC.kicad_sch, USB.kicad_sch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]
